KHP95/gradutaion_project/paper.pdf

KSME Template | 1
<응용논문> | DOI http:/ /dx .do i . org / 1 0 . 3 7 9 5 /KSME- A B . 2 0 1 4 . 3 8 . 0 . 0 0 0 | I SS N 1 2 2 6 -0 0 0 0

2288-0000(Online)

## 행성 탐사 로버 배터리 자동 교체 시스템 개발

### 김학중* · 민선기*† · 박경훈** · 유상은**† · 진상민*** · 홍창민***† (지도교수 : 장대성)

* 한국항공대학교 항공 우주 및 기계공학과

### Planet exploration rover battery automatic replacement system development

Hak Jung Kim*

, Sun Ki Min*†, Kyoung Hoon Park**

, Sang Eun Yoo**†, Sang min Chin*** and Chang Min Hong***†

* Dept. of Aerospace and Mechanical Engineering, Korea Aerospace Nat’l Univ.

(Received July 8, 2020 ; Revised July 9, 2020 ; Accepted July 10, 2020)

Key Words: System Engineering(시스템 엔지니어링), Micro Controller Unit(마이크로 컨트롤러), Path Plan (경로 계획), Robot Arm(로봇팔), Manipulator(매니퓰레이터) Kinematics(기구학) End-Effector (엔드이펙터), Mechanical Engineering Design(기계설계)

초록: 배터리 교체가 필요한 상대 로버 근처에서 주어진 방향 정보를 이용하여 사용된 배터리를 수거하 고, 동체에 장착된 배터리를 꺼내어 상대 로봇에 삽입하는 다관절 로봇팔을 구현을 목표로 제작하였다. 시스템 엔지니어링 개념을 통하여 제한된 예산과 시간동안에 로봇팔 제작을 실시하였다. 실제 모델의

구동 환경은 지구가 아닌 화성을 목표로 하였기 때문에 지구에서의 구동 가능한 모델의 재료와 크게 상이하다. 제작시간 및 제작비용을 고려하여 실제사이즈와 동일한 Mock-Up 모델을 제작하였다.

Abstract: The goal was to implement a multi-joint robot arm that collects the used battery by using the given direction information near the opponent rover that needs to replace the battery, takes out the battery mounted on the fuselage and inserts it into the opponent robot. Through the concept of system engineering, the robot arm was manufactured for a limited budget and time. Since the driving environment of the actual model is aimed at Mars, not Earth, it is significantly different from the material of the model that can be driven on Earth. In consideration of the production time and production cost, the same mock-up model was produced.

†Corresponding Author, dsjang@kau.ac.kr
Ⓒ 2020 The Korean Society of Mechanical Engineers

2 | 김학중․민선기․박경훈․유상은․진상민․홍창민
1. 서 론

1.1 Requirement

1) 500g의 배터리팩을 잡아서 하나의 장착 위치 에서 분리하고 다른 장착 위치에 삽입 및
결합할 수 있어야 한다.
2) 60초 이내에 자차의 배터리 팩을 꺼내고 상대 로버의 빈 장착 위치에 삽입해야 한다.
3) 60초 이내에 상대 로버의 배터리 팩을 꺼내고 자차의 빈 장착 위치에 삽입해야 한다.
4) 배터리 수거와 삽입은 자차에서 전방 좌우 ± 45, 거리 20cm~60cm 범위에 있는 상대 로버에 대해 수행할 수 있어야 한다.
5) 로봇팔 및 그 지지대와 제어 장치의 총 질량 합은 4kg 이내여야 한다.
6) 로봇팔은 운용될 환경 조건을 만족해야 한다.

1.2 Mission Statement – Hardware

로봇팔의 제어 특성과 여러 변수는 단순히 프로
그램 상에서만 발생하는 것이 아니라, 설계과정
과 실제 제작과정의 차이에서도 기인한다. 아무
리 설계가 이상적으로 잘 되어 있다 한 들 제작 과 조립을 고려하지 않았을 때, 자원 낭비로 이 어지며 이는 프로젝트를 진행함에 있어서 시간
지연 요소로 작용할 것이다. 이번 임무에 요구되는 로봇팔은 우주환경 내지

타 행성에서 정상적인 운용이 가능한 로봇팔로, 자중의 최소 1/8에 해당하는 물체를 자유롭게

Pick & Place가 가능해야 한다. 이를 충족하기 위해서는 다음과 같은 제약조건이 따른다.
- 더 가벼운 로봇팔은 우주환경까지의 운송비를
절약하는데 기여한다.
- 심한 온도차에서도 정상적인 작동이 가능해야
한다.
- 기계적으로 충분한 강도를 가져야 한다.
- 임무수행 범위 내에서 자유로운 동작 및 임무 수행이 가능해야 한다.

1.3 Mission Statement – Simulation

로봇팔이 원하는 효율적으로 원하는 운동을 수

학 공식적으로 계산하며 미션을 수행할 수 있도
록 로봇팔의 특성을 조절하는 역할을 한해야 한
다. 물체를 자유롭게 Pick & Place 하기 위해서 최적의 설계를 하기 위해서 다음과 같이 진행하
고 있다.
- 로봇팔 모델링을 통해 좌표축 및 이동행렬을
결정한다.
- 자코비안(Jacobian) 행렬식 계산을 통해 각 조 인트의 화전각과 각 링크 길이를 통한 엔드이펙
터의 위치 및 자세를 유도한다.
- 엔드이펙터가 이동할 경로의 좌표를 시간축에
대하여 정의하는 Path-plan
⦁ Wrist의 path-plan
⦁ 엔드이펙터의 path-plan
- 시뮬레이션 수행
- 카메라로부터 입력받은 정보에 대한 정보를
받아 그에 맞게 path-plan을 계산하고, 동작 을 어떤 순서로 진행할지에 대해 흐름 전개

1.3 Mission Statement – Software

로봇팔을 원하는 운동으로 작동시키기 위해서는
적절한 코딩과 그에 알맞은 프로세서가 필요하
다. 이를 충족시키기 위해서 소프트웨어팀은 다
음과 같은 기술을 충족시켜야 할 것이다.
-프로세서 선정 및 프로세서에 알맞은 코딩 능력 발전
-영상정보를 받기 위한 통신
-정보를 통하여 서보를 구동
-순차적인 동작을 구동하기 위한 알고리즘

KSME Template | 3

1.4 PBS

우리는 Design을 체계적으로 알아보기 위해 PBS 를 작성하였고 다음과 같다.

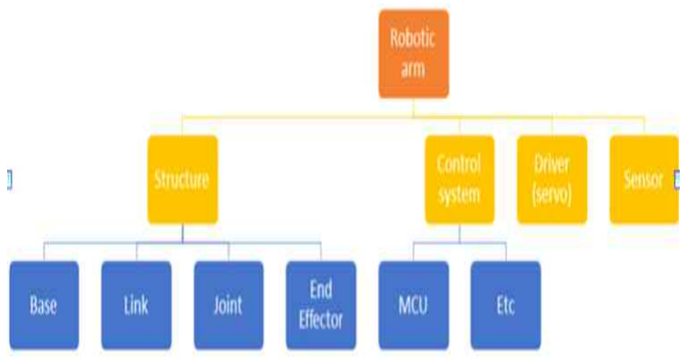
[picture p3: figure]

-Structure: 로봇팔의 기계적인 구조
-Base: 로봇팔이 설치될 지지대
-Link: 관절과 관절을 이어주는 팔
-Joint:구동기를 설치해 움직임을 만들어내는 관 절부품
-End effector: 로봇팔의 끝에 달려 배터리를 교환하는 작업(Ex. grip, rotate)을 수행하는 장 치(ex. Gripper or em holder)
-Control system: Driver의 제어를 수행하기 위 하여 필요한 회로 등을 포함한 전자장비들의 집
합
-MCU: 마이크로 컨트롤러 유닛. 프로그램이 설치 되어 구동기에 신호명령을 내리는 장치
-Driver: 구동기. Control system의 신호를 받아 움직임을 만들어내는 장치 (Ex. Servo, linear motor, 유압장치 등)
-Sensor: 제어에 필요한 각종 외부 정보들을 수 집하는 장치

1.5 V Shape Diagram

Requirements 중 설계 및 제작에서 가장 중요하 게 고려해야 할 부분은 1, 4, 5, 6번이며, 2번 및 3번의 달성을 위해서는 설계가 소프트웨어 디 자인에 대하여 친화적일 필요가 있다. 다시 말해
모든 | 조건을 | 고려해야 | 하며, | 이를 | 고려한
V-shape diagram은 아래와 같다.

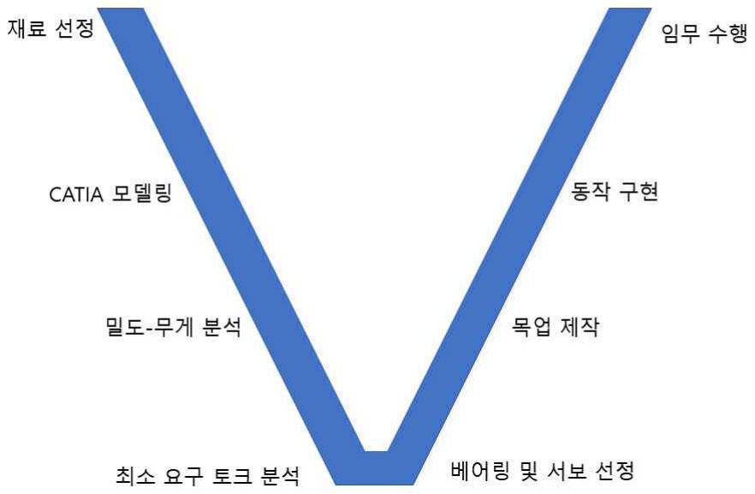
[picture p4: figure]

Fig. 2 Hardware Design V shape diagram

2. 본 론

2.1 design model weight expectation

무게 대비 payload 조사: 우리는 설계를 시작하 기에 앞서서 로봇 팔이 과연 500g을 들려면 어느 정도의 무게여야 하는지 알아보기 위해서 자료를
찾아 10kg 미만의 사례 중 10개를 선택하여 보간 한 결과 다음과 같이 얻을 수 있었다,

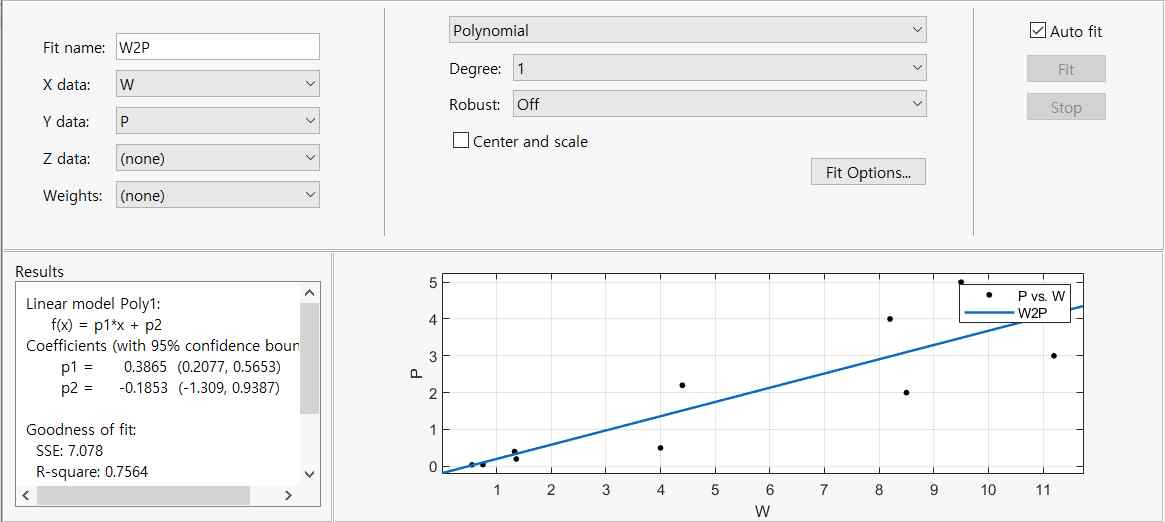
[picture p5: figure]

Fig. 3 weight-payload root mean square plot

식에 4kg을 대입한 결과 충분히 500g을 이상을 들 수 있다는 결과가 나왔다.

2.2 Hardware

2.2.1 Material Selection

로봇팔의 재질은 무게와 페이로드에 따라 적절
히 선정해야 한다. 또한, 지상에서 운용되는 로 봇암과 달리 항공우주분야에서 운용하는 로봇팔
은 무게가 운용 효율과 직결되어 로봇팔 자체의

4 | 김학중․민선기․박경훈․유상은․진상민․홍창민

무게에 대한 합리적 고려가 필요하다. 따라서 재
질 선정에 앞서 고려할 수 있는 재료들과 화성탐
사선 Curiosity의 로봇팔에 사용되었던 재료를 주요 특성에 따라 정렬하였다. Ti6Al-
| 4V | Al-707 5 | AS4/35 01-6 | PEEK | AL606 1
밀도 (g/cc) | 4.43 | 2.81 | 1.60 | 1.26-1 .50 | 2.70
탄성계수 (GPa ) | - | 71.7 | 147, 10.3 | 2.2-6. 48 | 68.9
인장강도 (Mpa ) | 896 | 276 | 2280 | 48-26 5 | 117
극한 인장 변 형률 (%) | - | 17 | 1.5 | 1.5-11 0 | 25

열팽창계수
(
/℃) | - | 23.6 | -0.9 | 4.7-
600 | 25.2

Table. 1 materials used in Curiosity, Mars Probe, and Properties of CFRP(UD type) and PEEK

인장강도 및 열팽창계수만 고려한다면 CFRP인
AS4/3501-6이 월등한 성능을 가지고 있음을 알 수 있다. 그러나 다른 재질에 비하여 이방성 재 질이고 단가가 비싸며, 충격에 의한 재료의 파괴 가 지속적으로 진행되는 점으로부터 우주쓰레기
및 행성 내 모래폭풍 등의 외부 충격에 취약하다 고 판단하였다.
Ti6AL-4V은 티타늄 특수합금으로서 물성이 뛰어 나지만 가공이 어려워 단가 상승이 예상되며, 재 료를 구하는 것 부터가 쉽지 않다. Al 7075의 경 우 특수한 경우를 제외하고 대중적으로 사용되지
않아 제한된 예산 하에서 실제 제작에 활용하기
어렵다고 판단하여 Al6061을 주 재료로 선정하 였다.

2.2.2 Design

2.2.2.1 Robot arm design
로봇팔의 형상은 임무수행을 위해 최적화되어야
한다. 또한 제한된 예산 내에서 Requirement를 만 족하기 위해서는 재료를 고려한 설계가 필수적이
다.

앞서 로봇팔의 주재료를 Al6061으로 하기로 하였 으므로 이를 기반으로 요구되는 로봇팔의 링크
규격을 단순 보 가정을 통해 구하였다.

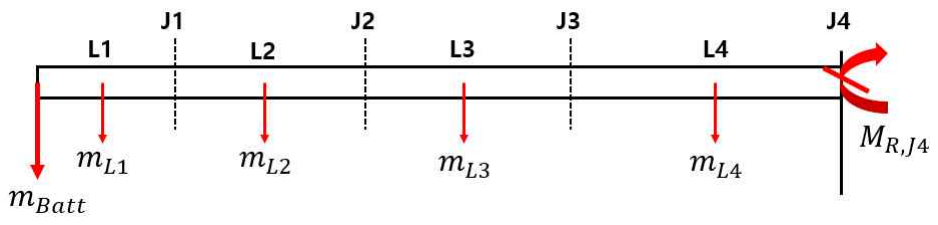
[picture p6: figure]

Fig. 4 단순 보 가정, 집중하중으로 가정한 로봇 팔의 링크

안전계수를 4로 하였을 때, Al6061을 재료로 하 는 원형 링크의 규격은 D25 1T이다. 또한, 이때 각 조인트에 가해지는 토크는 다음과 같다.

이러한 결과를 기반으로 서보를 선정하고, CATI A를 이용하여 모델링 한 결과는 아래와 같다.

| 서보무게 (g) | 암 무게 (g) | 암 길이 (cm) | 총 모멘트 (kg.cm)
J4 | 135 | 250 | 12 | 9.48
J3 | 60 | 112 | 20 | 30.1
J2 | 65 | 128 | 20 | 54.42
J1 | 900 | 171 | 30 | 122.01

Table. 2 The amount of torque applied to the joint

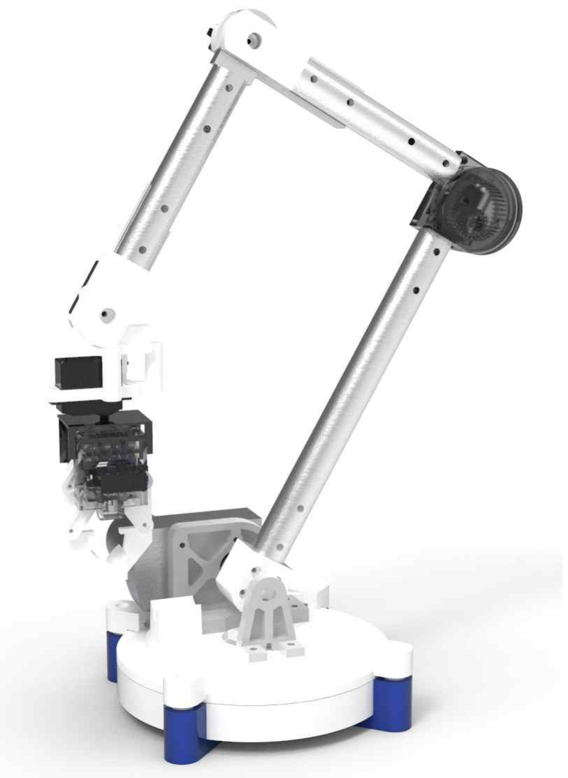
[picture p7: figure]

Fig. 5 Final design completed/manufactured Robot arm model

KSME Template | 5

이때 재료는 PLA(Polylactic Acid)를 사용했으며, 이는 실제 모델에서는 사용하지 않는 재료이지

만, 프로젝트의 기한이 최대 1년인 점, 예산이 학 기당 최대 100만원으로 한정된 점, 충분한 해석 및 선행 연구가 진행되지 못한 점으로부터 프로
젝트 진행과 함께 모델링의 수정이 불가피하므로
3D printer를 이용해서 설계 수정 및 즉시 반영을 통해 단기간에 목표를 달성하기 위해 사용하였
다. 2.2.2.2 End-Effector Design

-Requirements

배터리팩을 잡고 배터리팩의 무게+로봇팔 작
동시의 관성력 을 견딜 수 있어야 한다. 전체질 량은 200g 이하여야 한다.

-설계품 추정

설계에 앞서 시판중인 엔드이펙터의 설계를 살펴
보았다. 그 결과 공통적인 구조를 발견하였다.

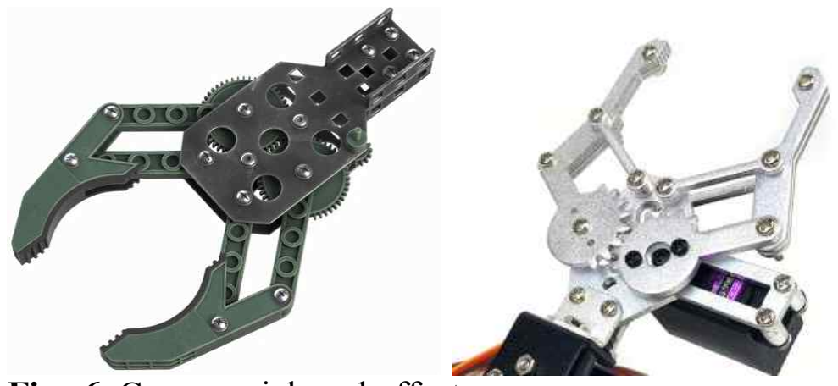
[picture p8: figure]

Fig. 6 Commercial end-effector

위와 같이 두 개의 평행한 링크가 그리퍼에 연결 되어 작동하는 방식이다. 그리퍼가 서로 대칭하
게 동작하기 때문에 내부 기어도 대칭구조로 되
어있다. 위의 구조를 토대로 설계하였다.

-그립과정에서 배터리팩 그립과의 간섭 해결

그림에서 표현된 바와 같이 그리퍼는 링크의 길
이를 반지름으로 하는 원호를 그리며 움직인다. 이 과정에서 배터리 그립과 그리퍼와의 간섭을

방지하려면 그리퍼가 그리는 자취를 따라서 배터
리팩의 그립을 설계하거나 반대로 배터리팩의 그
립이 그리는 자취를 따라서 배터리팩을 설계하여

야 한다. 배터리팩의 그립부분이 이미 설계가 되 어있었기 때문에 후자를 택하였다.

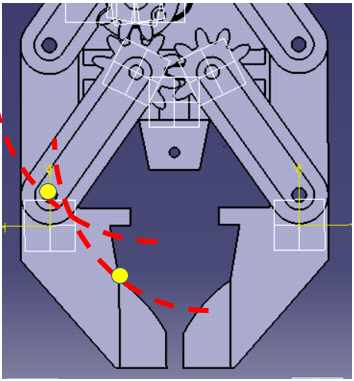
[picture p9: figure]

Fig. 7 Trajectory of gripper - 배터리팩 하중에 의한 토크 계산

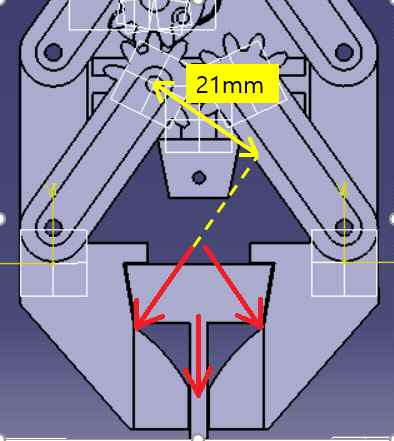
[picture p10: figure]

Fig. 8 Load appled and Moment arm

그림처럼 배터리팩을 잡았을 시에 배터리팩의 하
중의 작용점의 모멘트암의 길이는 21mm 이다. 하중과 모멘트를 정역학적으로 계산해보면 다음

과 같다.
cos ×
대칭구조이기 때문에 양쪽에 하중이 걸리는 것을
고려하면 총 모멘트는 다음과 같다. × ×

서보모터의 사양이 2.8~3.4 kg·cm 이므로 여유 가 있는 것을 알 수 있다. 그러므로 기어비 1:1 이 충분한 것으로 판단하였다.

6 | 김학중․민선기․박경훈․유상은․진상민․홍창민
- 내부 기어 설계
다음은 인벌류트치형을 그리기 위한 수치이다. 잇 수 N | 10
피치지름 d | 15 mm
입 력 각 a | 20 deg
- 모 듈 m= | m=1.5 mm

기초원지름 =14.0954 mm = cos

디덴덤지름 | =11.25 mm
어덴덤지름 | =18 mm

Table. 3 Gear Design Data

위 수치를 가지고 인벌류트 곡선을 그리고 기어
를 모델링하였다. 아래는 전체 모델링 결과이다

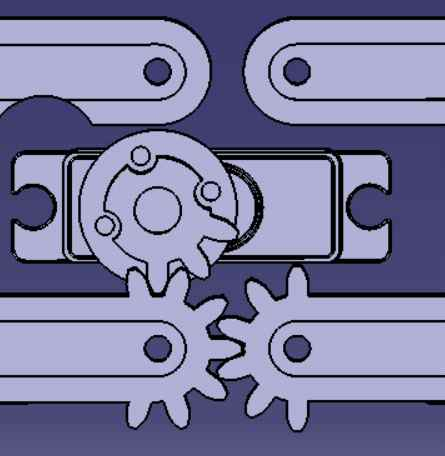
[picture p11: figure]

Fig. 9 Internal Gear structure

기어를 회전시켜가며 이의 간섭이 없음을 확인하
였다. 서보모터와 연결된 기어는 작동각도 55 에 필요한 이를 빼고 생략하였다.
2.2.3. Feature
이러한 로봇팔을 제작하는 과정에서 발생 가
능한 이슈들을 빠르게 피드백하기 위해선 높은
수준의 유지보수성이 요구되며, 이를 위해 전 파 트 볼트-너트 채결 방식을 통해 조립하였다. 볼팅 과정에서 발생하는 마찰열에 의해 3D Printer 출 력물이 적절히 변형되어 결합을 보다 단단하게
유지할 수 있었으며, 결합강도가 충분하지 않은

곳에는 플렌지 너트를 이용해 채결하여 스스로
풀리지 않도록 하였다.또한 3d Printer 출력 시 불 필요한 Support 생성에 의한 원재료 및 시간, 인 적 자원 낭비를 방지하기 위하여 설계 단계에서
서포트가 요구되지 않는 구조를 설계하는 것을
최우선 순위로 디자인하였다. 이를 위해 z축 방 향에서 형성되는 빈 공간을 최소화하고, 출력 시 에 적절한 온도 및 밀도 설정과 함께 서포트가
형성되는 각도를 조절하여 출력함으로서 보다 높
은 수준의 결과물 생산이 가능했다. 서보모터에 의한 동력전달의 경우, 소형 서보

모터의 축으로 사용되는 스파인으로부터 출력한
조인트가 미끄러지지 않게 하고, 반복된 움직임
으로 인해 마모되는 것을 방지하는 것이 중요하
다. 또한 기어 등 추가 부품이 늘어날수록 동력 전달 효율이 감소하므로, 최대 동력 전달을 위해 서는 직접 연결하는 방식이 제일 높은 기계효율
을 가진다. 이러한 점으로, 기성 서보 혼을 설계 형상에 맞게 변경하여 사용함으로써 발생할 수
있는 부품의 마모, 동력전달 효율 문제 등을 해 결하였다. 또한 이러한 축이 작고 축에 수직한
힘에 약하여 축 변형, 더 나아가 서보 모터 파손 등의 문제가 발생할 수 있다. 따라서 반대편에는 이러한 수직한 힘에 의한 변형을 막아줄 축을
AL6061 축을 D-shape 가공하여 추가로 설치하였 으며, 축 방향 수직하중에 의한 처짐, 흔들림 등 을 해결할 수 있었다.

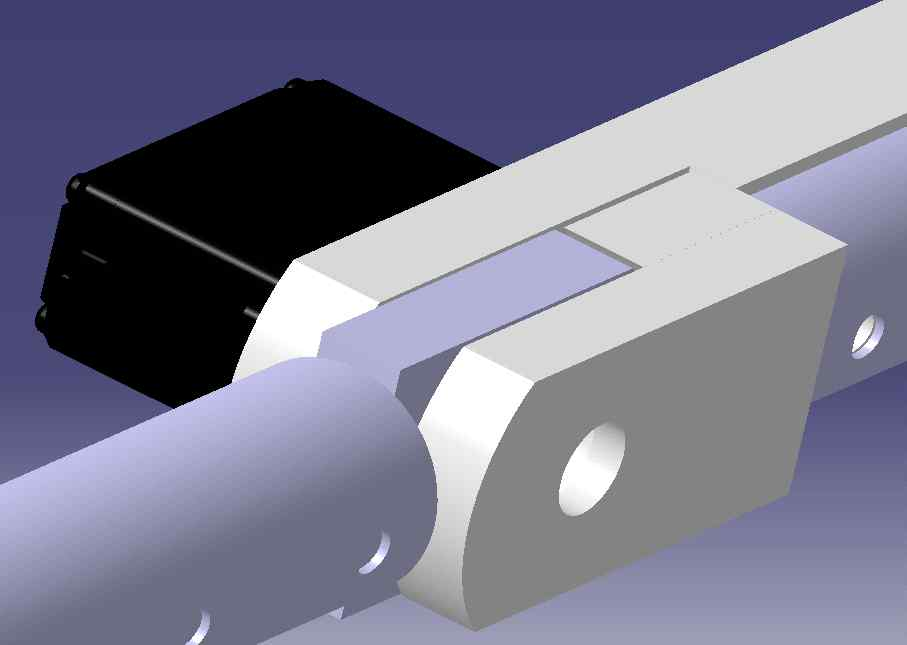
[picture p12: figure]

Fig. 10 Structure to prevent deformation by axial normal stress.

기저부의 경우, 작은 변형이 가장 큰 오차로 나 타나는 부분이므로 이를 방지하기 위한 롤러가이
드를 90도마다 설치하여 기저부 판의 구조적인
특성에 의한 흔들림을 방지하였다. 헤드에 8mm

KSME Template | 7

베어링의 일부분이 노출되어있어, m6볼트를 이용
하여 롤러가이드를 조립하게 되면 이러한 힘에
의해 베어링과 회전 플레이트가 접촉하게 된다. 이를 적절히 조절하면 흔들림을 잡는 동시에 원

할한 동작을 가능하게 할 수 있다.

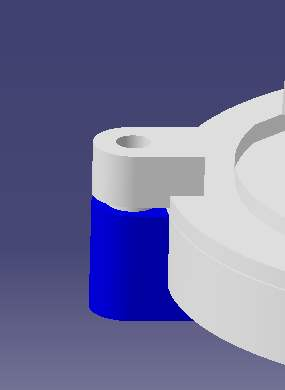
[picture p13: figure]

Fig. 11 Roller guide mounted on the base plate

2.3 Simulation

Requirements를 만족하도록 개념설계를 구체화하 고, 실제 제작에 앞서 가상의 정보를 가지고 실 제로 작동하는 일련의 과정을 구상 및 테스트해
보아야 한다. 시뮬레이션은 하드웨어 없이도 테
스트할 수 있으며, 알고리즘을 개발하고 시험하
기 위해 필요하다. 시뮬레이션을 통하여 업무분
담 및 테스트가 수월해질 수 있다.

2.3.1 Modeling

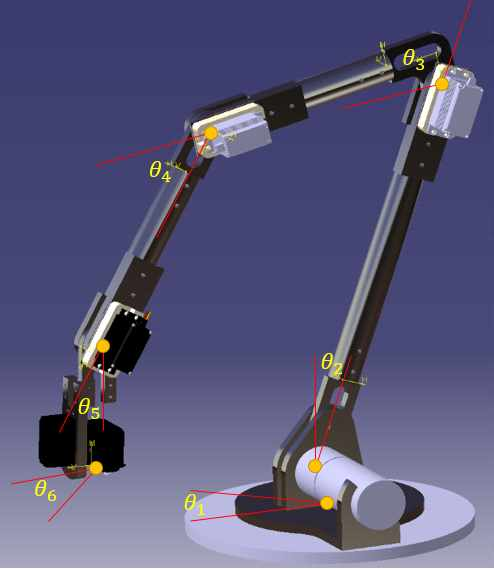
[picture p14: figure]

Fig. 12 Robot Arm

우선 6자유도로 모델링 하였다. 그 이유는 다음 과 같다. ① 5자유도의 경우 엔드이펙터와 지지대를 제외

한 로봇팔이 2자유도이므로 로버의 자세와 위
치에 대한 유연한 대응에 한계가 있다. ② 로버의 자세에 따라 엔드이펙터의 자세를 변

화시켜야 하므로 회전도 필요하다. 먼저 카티아로 전체적인 형상을 그려보고 이를

토대로 로봇공학 정기구학 스터디를 진행한 후
Universal 좌표계에서 엔드이펙터 좌표계까지의 Transformation 행렬을 만들어 보았다. 이를 통 해 엔드이펙터의 자세와 위치를 알 수 있다.
Transformation 행렬은 다음와 같다.

8 | 김학중․민선기․박경훈․유상은․진상민․홍창민

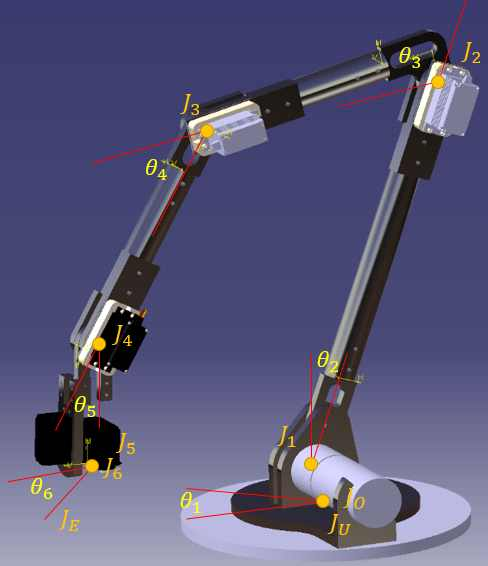
[picture p15: figure]

Fig. 13 Robot Arm

Ju=정면을 x, 왼쪽을 y, 위를 z로 하는
FLU좌표계로 설정
J0= 로 yaw 회전을 한 좌표계
J1=지지대로부터 높이만큼 이동한 좌표계
J2= 로 pitch 회전 후 L1길이방향으로 J2까지 이동한 좌표계
J3= 로 pitch 회전 후 L2길이방향으로 J3까지 이동한 좌표계
J4= 로 pitch 회전 후 L3길이방향으로 J4까지 이동한 좌표계
J5= 로 pitch 회전 후 L4길이방향으로 J5까지 이동한 좌표계
J6= 로 yaw 회전 후 L5길이방향으로 J6까지 이동한 좌표계
Je= 로 roll 회전 후 엔드이펙터 grip point까지 이동한 좌표계

위에서 J1에서 J2로 이동하는 과정에서 을

곱해준다. 여기에서 x축 중심으로 -90 도 회전 후 y축 중심으로 -90 도를 회전한다. 이는 로봇 공학에서 통상적으로 x축을 링크길이 방향, z축 을 조인트 회전축 방향으로 맞추기 때문에 이를
만족시키기 위함이다.

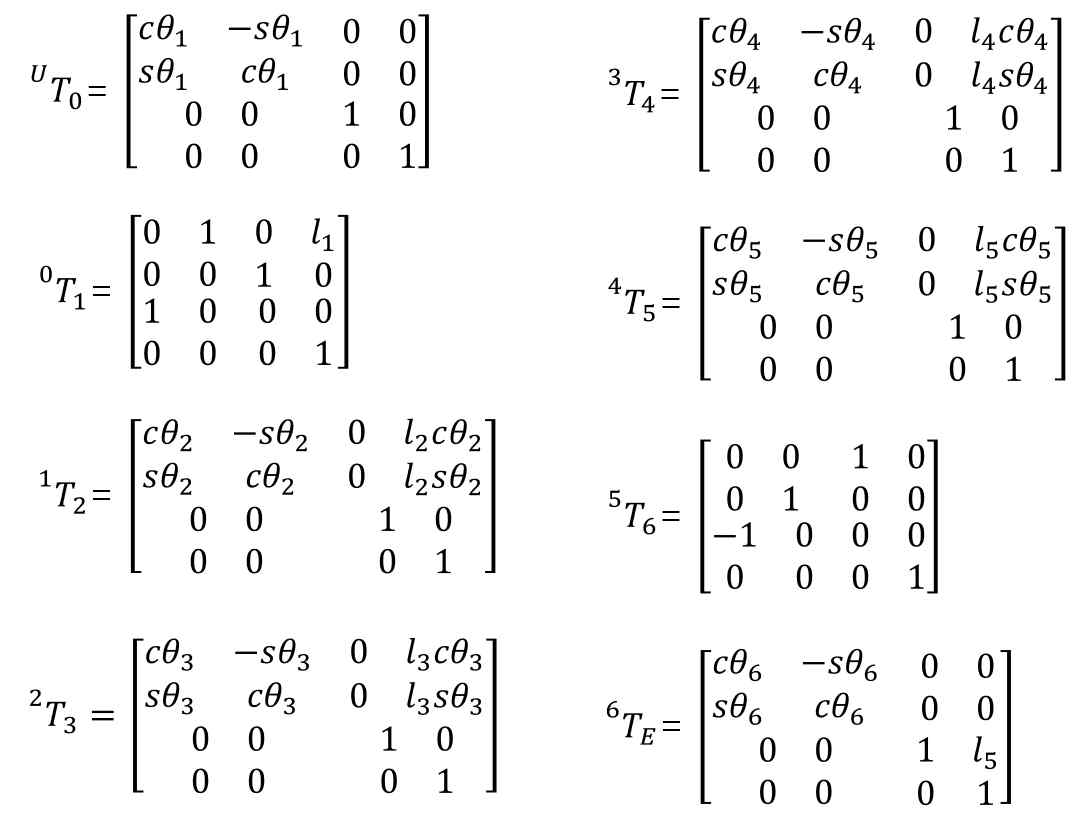
[picture p16: figure]

Fig. 14 Translation Jacobian Matrix
위 행렬을 모두 곱하게 되면 Universal 좌표계에 대한 엔드이펙터의 자세와 위치를 알 수 있다. 하지만 여기에서 지지대와 1번 조인트 사이의 거

리와 엔드이펙터를 생략하여 단순화 시켜서 시뮬
레이션을 진행하기로 하였다. 그 이유는 다음과
같다. ① 모두 계산할 경우 식이 매우 복잡해진다. ② 로버 배터리의 자세에 따라 엔드이펙터의 자

세도 변하여야 한다. 이 경우 4 번 조인트의
좌표를 배터리에서 수직방향으로 엔드이펙터 길
이만큼 떨어진 지점에 일치하도록 제어하는
것이 편하다. 단순화된 로봇팔을 FLU 좌표계로 나타내면 다음

과 같다.

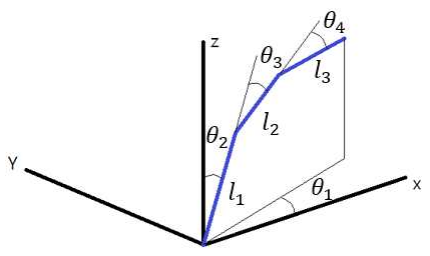
[picture p17: figure]

Fig. 15 Link coordinate

이를 토대로 끝점의 위치좌표를 계산하면 아래와

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

10 | 김학중․민선기․박경훈․유상은․진상민․홍창민
1)
| 을 동시에 제어하는 방법

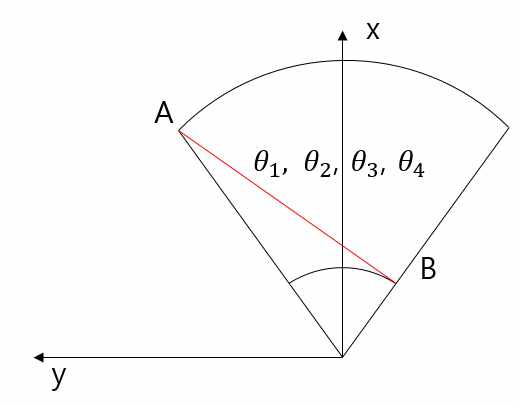
[picture p18: figure]

Fig. 16 Sequence Case 1

위 그림은 경로를 xy평면에 정사영시킨 것을 나 타낸 것이다. 목적지점 A와 B 사이를 직선으로 연결한 최단 경로(빨간색) 를 따라 wrist를 이동 시키는 것이다.

- 을 시간에 대한 함

수로 정의하는 것이 필요하다. ※ 로봇팔이 두 지점 사이를 이동하면서 가 변

함에 따라 wrist와 원점사이의 거리가 점점 작아 지게 된다. 이 경우 의 각속도를 조절해줄 필

요가 있다. 그리고 의 변화에 따라 wrist의 위

치가 결정된다. 이 상황에서

- 중에서

redundancy가 한 개 발생하여

- 의 값이

무수히 많아진다. 따라서

- 중 한 각도의

값을 정해주어야만 나머지 두 각을 유한하게 제
어할 수 있을 것으로 예상된다. 시뮬레이션을 통해 이 제어가 가능한지 알아보고

만약 불가능하다면 자유도를 제한하여 나머지 두
각을 유한하게 제어하는 방법을 모색하기로 한
다.
2) 제어와
- 제어를 시퀀스를 나눠

서 하는 방법

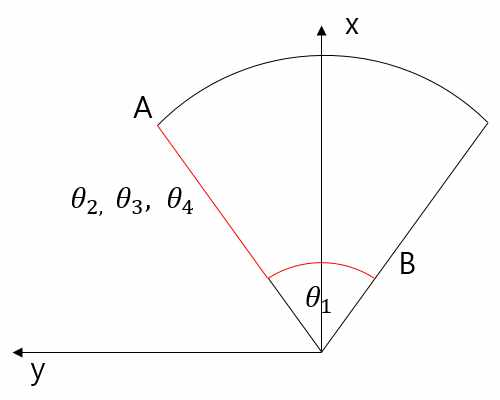
[picture p19: figure]

Fig. 17 Sequence Case 2

지지대 | 회전()과 | 로봇팔 | 조인트회전

(

- )을 나눠서 제어하여 목적지에 도달하

는 것이다. 이 경우도 마찬가지로 wrist의 위치 에 따른

- 값이 무수히 많다. 다만 나눠서 제어하므로 2차원화 되어 비교적 제

어가 간단해진다. 하지만 경로가 길어져 임무 수 행에 시간 소모가 커지는 단점이 있다. 각 방법의 장단점을 정리해 보면 다음과 같아진

다.

최종적으로는 | 1)의 | 방식을 | 채택하였으며,
pathplan과 역기구학(인버스 자코비안)을 이용하 면 redundancy가 발생하지 않음을 확인할 수 있 었다.
| 동시제어 | 시퀀스를 나눠서 제어
장점 | 경로가 짧다. 임무 수행 시간이 짧아진다. 배터리 소모가 적 다. | 연산이 비교적 간 단하다. 제어가 쉽다. 단점
| 더 많은 연산이 요구된다. 제어가 어렵다. | 경로가 길다. 임무 수행 시간이 길어진다. 배터리 소모가 크

다. Table. 6 Pros and Cons of path plan methods

KSME Template | 11

2.3.4 Simulation Production Details

①실제 모델 길이에 따른 링크 및 엔드 이펙터
표시
②자코비언 행렬을 이용한 패스 플래닝
③배터리 교체 알고리즘에 따른 경로 설정
④배터리 교체 그립 구현
⑤제한 영역 설정

제한 영역 설정 고려 사항

①링크의 길이를 통해서 나오는 최대 도달거리에
의한 제한 영역

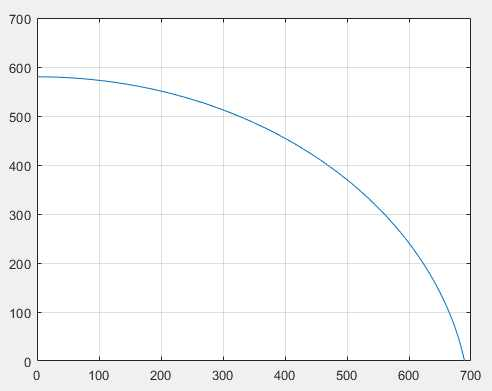
[picture p20: figure]

Fig. 18 Maximum Reach length

그래프의 원점이 기저부의 회전중심이며 곡선 이
내의 영역에서는 안정적인 이동이 가능하다. ②구조적 한계의 각도 제한으로 인한 제한 영역

구조적 각도에 의해 최대각도 혹은 최소각도가
제한된다. 토크를 위해 서보 작동각도가 제한된
다. 시뮬레이션을 통해 다양한 조합을 시도하여
임무지역을 만족하며 가장 넓은 작동범위를 가지
도록 그리고 기저부 작동제한 영역이 배터리 보
관함위치와 겹치지 않도록 가장 적절한 각도 제
한을 선정하였다. 제한 각도는 아래와 같다. 각도를 제한하여 시뮬레이션한 결과는 아래와 같

다. 파란 지역은 조인트 중 하나라도 작동범위를

넘어서는 구역을 표시한 것이며, 검은 지역은 튕 김 구역(물리적으로 링크의 길이가 부족하여 불
가능한 구역)을 표시한 것이다.

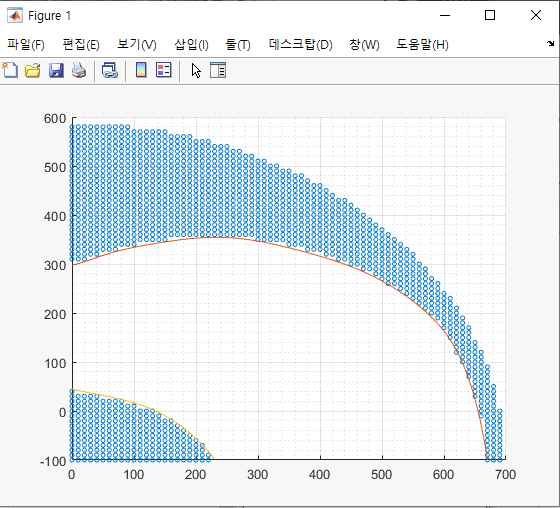
[picture p21: figure]

Fig. 19 Reach length limitation
위의 그래프의 결과를 통해 offset을 두고
polynomial line fitting하여 제한 영역을 설정 하였다. 제한 영역에서는 로봇암이 작동하지 않
으며, 목표지점을 재입력 하도록 하였다.

2.3.4Simulation Sequence

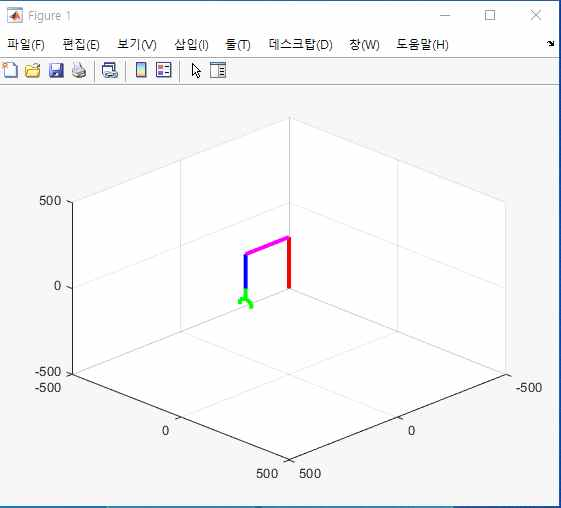
[picture p22: figure]

Fig. 20 Standby position

-85°≤﷐﷯≤ 90° <범위: 175도> | 37°≤﷐﷯≤ 107° <범위: 70도>
1°≤﷐﷯≤ 142° <범위: 140도> | -40°≤﷐﷯≤ 90° <범위: 130도>

Table. 7 Operating range of each joint

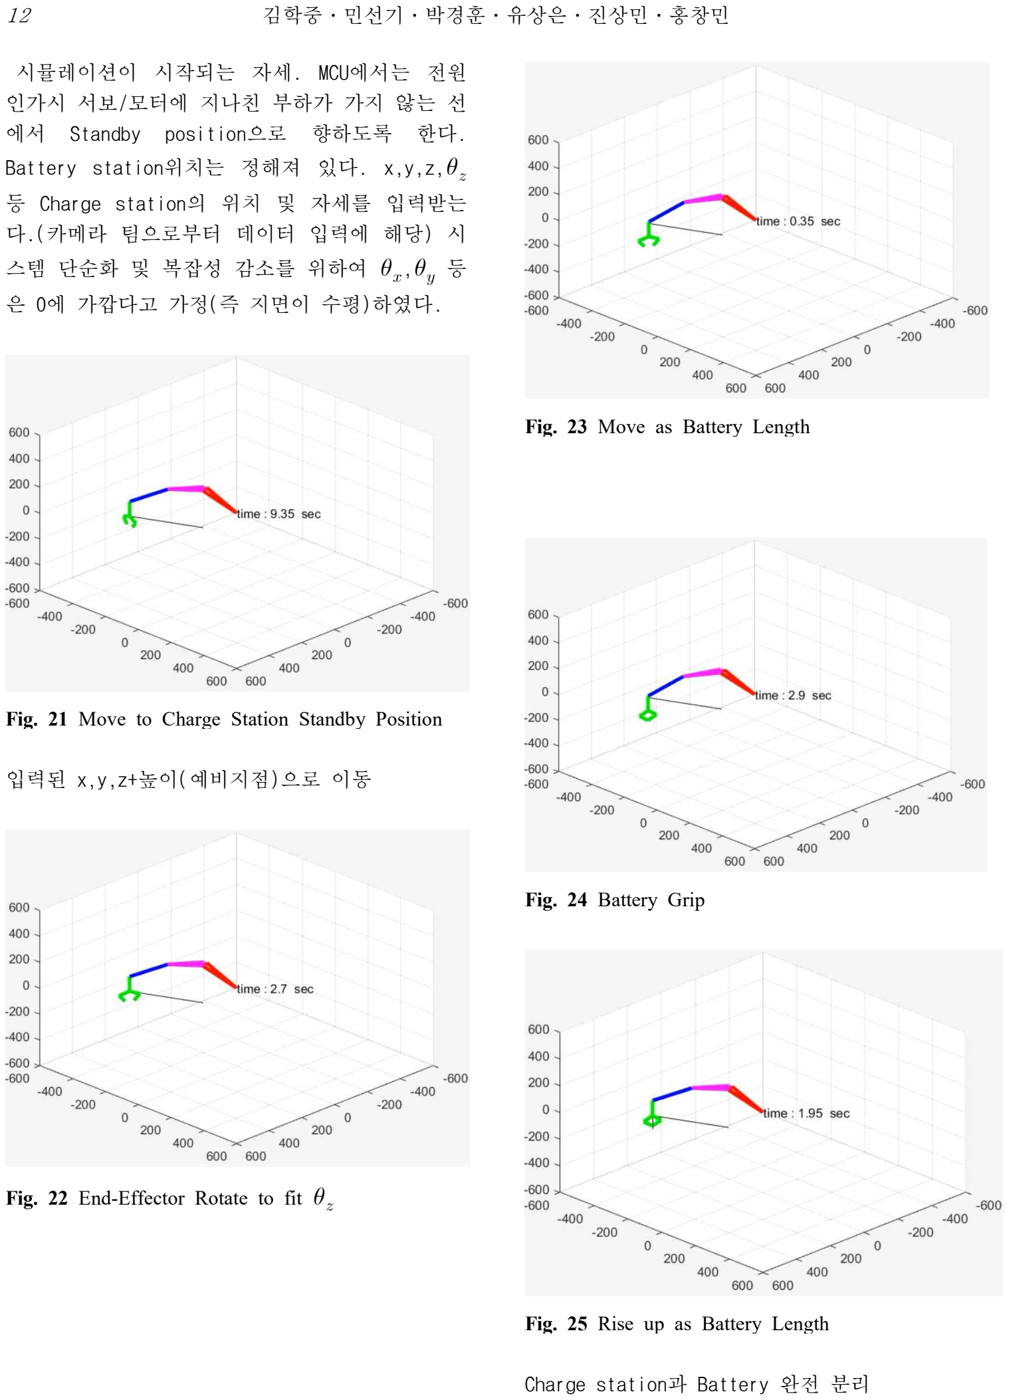
[picture p23: page 12]

12 | 김학중․민선기․박경훈․유상은․진상민․홍창민

시뮬레이션이 시작되는 자세. MCU에서는 전원
인가시 서보/모터에 지나친 부하가 가지 않는 선
에서 Standby position으로 향하도록 한다. Battery station위치는 정해져 있다. x,y,z, 등 Charge station의 위치 및 자세를 입력받는

다.(카메라 팀으로부터 데이터 입력에 해당) 시 스템 단순화 및 복잡성 감소를 위하여 , 등

은 0에 가깝다고 가정(즉 지면이 수평)하였다.

Fig. 21 Move to Charge Station Standby Position

입력된 x,y,z+높이(예비지점)으로 이동

Fig. 22 End-Effector Rotate to fit

Fig. 23 Move as Battery Length

Fig. 24 Battery Grip

Fig. 25 Rise up as Battery Length

Charge station과 Battery 완전 분리

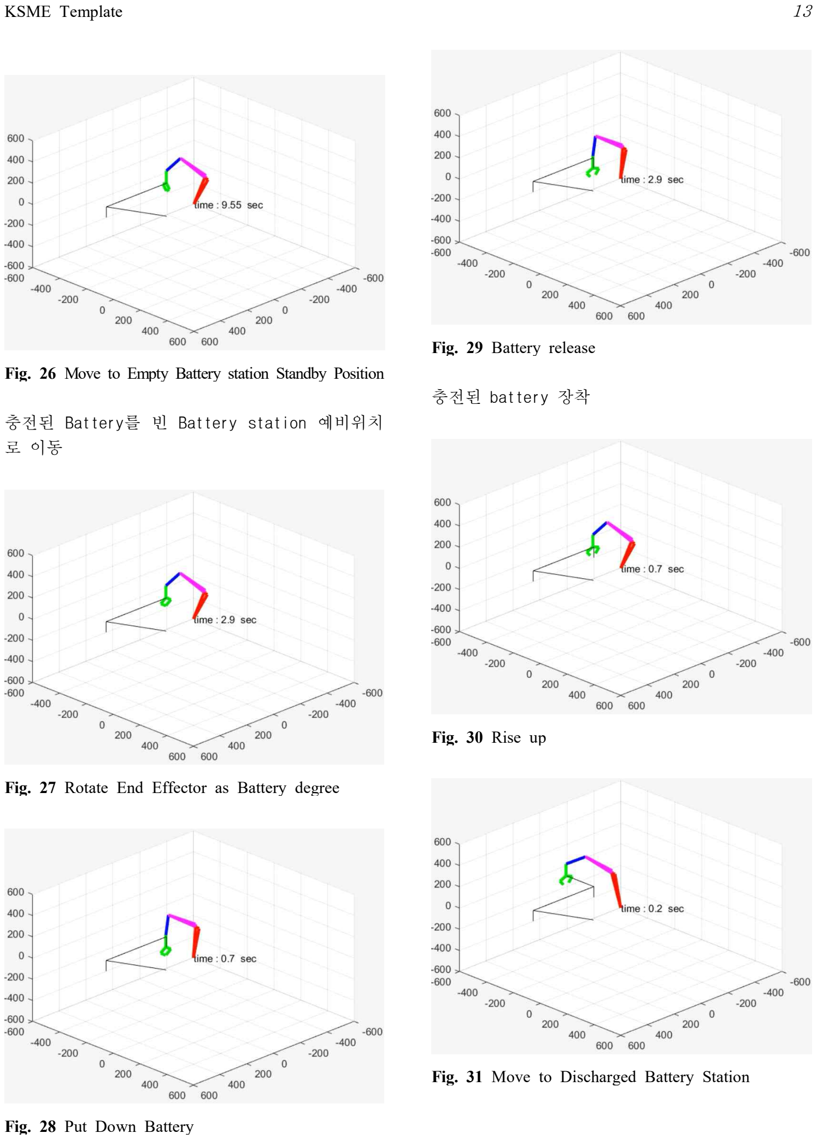
[picture p24: page 13]

KSME Template | 13

Fig. 26 Move to Empty Battery station Standby Position

충전된 Battery를 빈 Battery station 예비위치 로 이동

Fig. 27 Rotate End Effector as Battery degree

Fig. 28 Put Down Battery

Fig. 29 Battery release

충전된 battery 장착

Fig. 30 Rise up

Fig. 31 Move to Discharged Battery Station

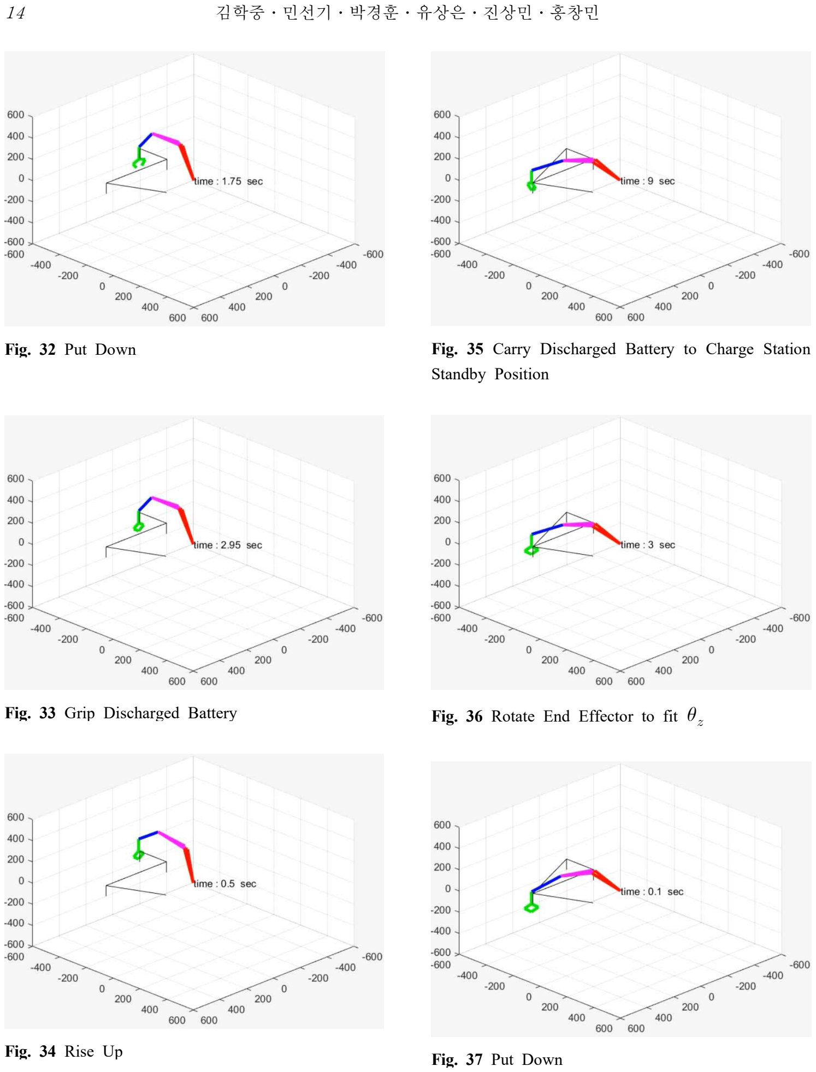
[picture p25: page 14]

14 | 김학중․민선기․박경훈․유상은․진상민․홍창민

Fig. 32 Put Down

Fig. 33 Grip Discharged Battery

Fig. 34 Rise Up

Fig. 35 Carry Discharged Battery to Charge Station Standby Position

Fig. 36 Rotate End Effector to fit

Fig. 37 Put Down

KSME Template | 15

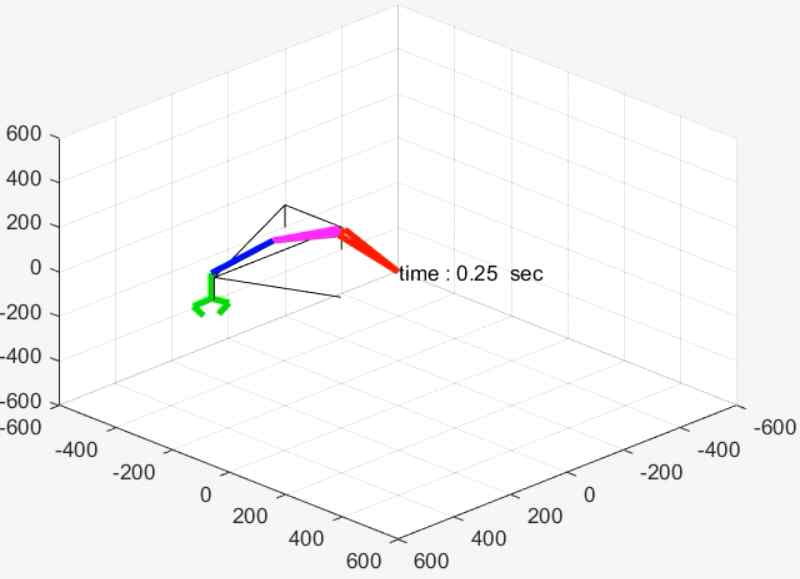
[picture p26: figure]

충전시작

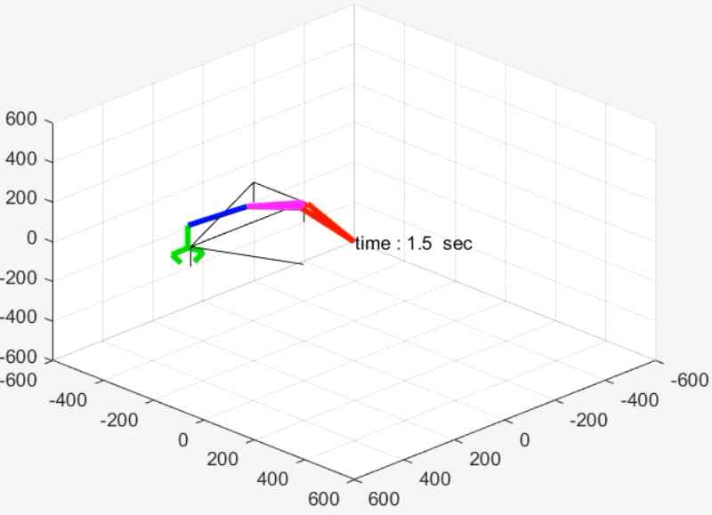
[picture p27: figure]

Fig. 39 Rise Up

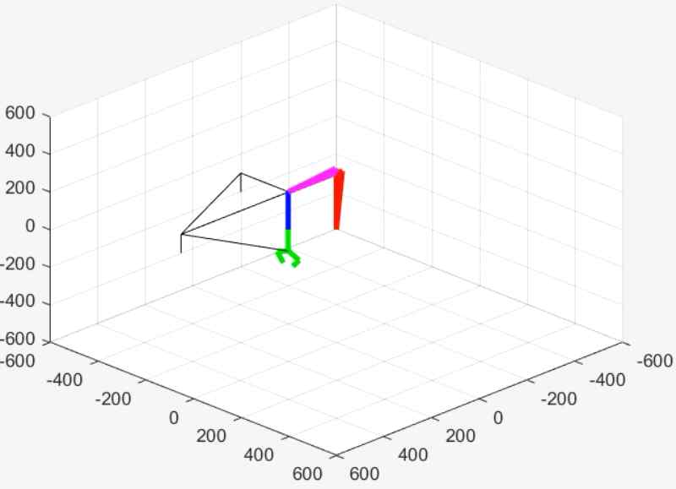
[picture p28: figure]

Fig. 40 Come Back to Standby Position

다음 명령 대기.

2.4 Software

2.4.1 Hardware configuration

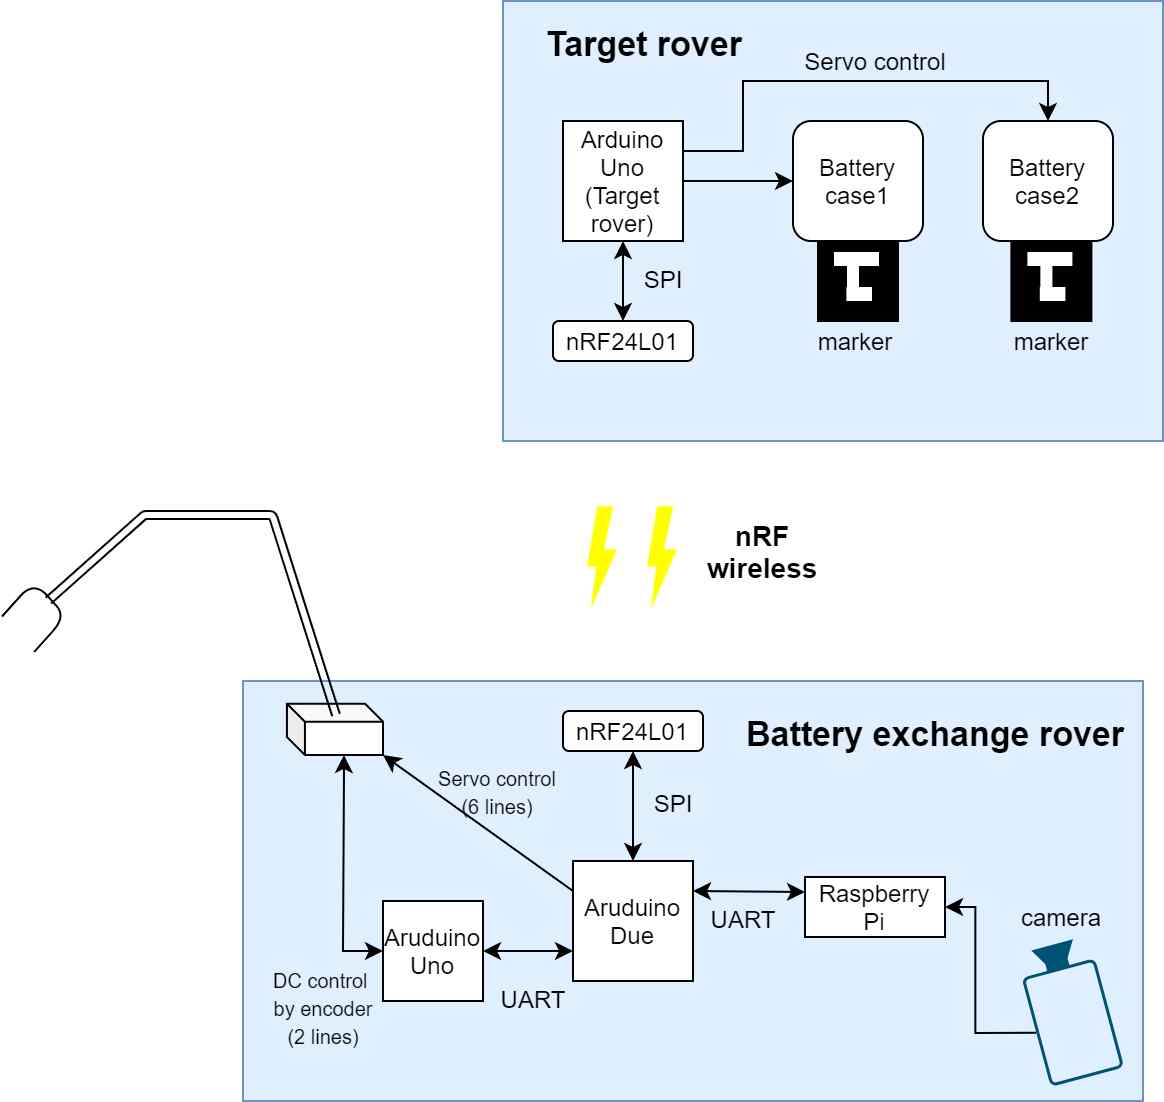
[picture p29: figure]

Fig. 41 Rover hardware design
위 그림은 로봇팔의 구성도를 나타낸 그림이고
각각의 구성요소들에 대한 설명은 다음과 같다. Target rover의 구성품

l nRF24l01
이 무선통신 모듈은 Target rover로부터 준비교체 명령을 받아 이를 Arduino uno에 전달하는 역할 을 한다. nRF모듈을은 갸격이 저렴하고 안테나 없이도 50m정도까지 안정적인 통신을 진행할 수 있어 임무를 수행하는데 적합하다. l Arduino uno

Target rover를 제어 한다. nRF로부터 받은 데이 터를 처리하여 배터리 케이스에 달려있는 모터에
명령을 보내 임무수행 전 준비를 한다. Battery exchange rover의 구성품

l Raspberry Pi
카메라로 배터리의 마커를 영상처리하여 UART 통 신으로 Arduino Due에 배터리 마운트 좌표 및 각 도를 보낸다. l Arduino due

아두이노 프로세서중 가장 높은 처리속도와 변수
저장공간을 가지고 있다. Raspberry Pi와 Uno, nRF24L01 및 컴퓨터와 통신하여 임무수행을 위한 메인프로그램을 구동한다.

Fig. 38 Battery Release

16 | 김학중․민선기․박경훈․유상은․진상민․홍창민

l Arduino uno
로봇 팔의 기저부에 있는 DC모터 2개의 별도 피 드백 루프를 구성하고, Calibration값들을 저장 하는 역할을 한다.

2.4.2 Algorithm
임무수행 알고리즘은 아래와 같다.

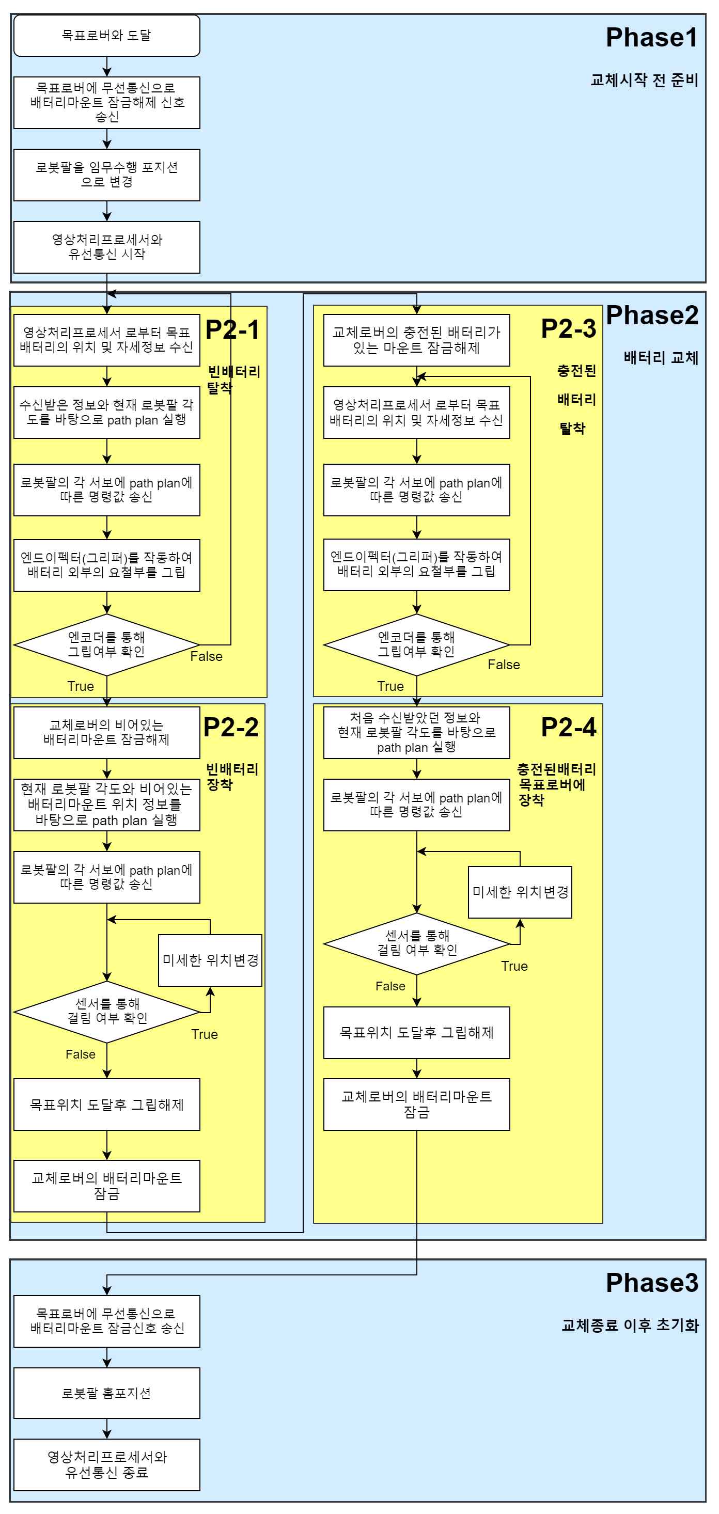
[picture p30: figure]

Fig. 42 Mission algorithm
임무수행은 총 3단계의 Phase로 나뉘어 진행된

다.
Phase1은 교체전 준비를 진행하는 단계이며, 이 때 목표로버와 무선통신하여 배터리 마운트의 덮
개부분을 열고, 영상처리 프로세서인 라즈베리
파이와 통신하여 배터리 마운트의 좌표를 수신한
다.

Phase2는 path-plan을 수행하여 배터리 교체작업 을 실행하는 단계이다. 이때 배터리 교체작업은
4개의 sub-phase로 나뉘어 진행되며, 각 단계마 다 path-plan을 진행한 후 확인작업을 실행하고, 이상이 없을시 다음 sub-phase로 넘어가는 방식

이다. 각 sub-phase는 좌표로 이동->하강->그립 또는 그립해제->상승 의 작업을 실행하며, 이에 따라 sub-phase당 path-plan의 실행횟수는 3번이 다. 이에따라 Phase2에서 총 12번의 path-plan이 이루어진다.

Phase3는 배러티 교체작업 이후 마무리작업을 진 행하는 단계이다. 무선통신을 통해 목표로버의
배터리마운트 덮개를 다시 덮고, 로봇팔을 홈포
지션으로 되돌려 보내며, 영상처리 프로세서와도
통신을 종료하는 일련의 과정을 실행하여 로봇팔
을 교체임무 시작전의 상황으로 되돌린다.

2.4.3 Software Configuration
임무수행과 이를 보조하기 위한 기타 기능들을
구현하기위해 두 아두이노 프로세서의 프로그래
밍을 진행하였다. 각 프로세서에 구현된 기능은
아래와 같다. 아두이노 듀에(Due)

l 컴퓨터와 UART 및 Bluetooth 통신 l nRF24L01 모듈과 SPI 통신
l 라즈베리파이와 UART 통신
l Uno와 UART 통신
l 캘리브레이션
l DC 또는 Servo모터의 수동조작
l 좌표입력을 통한 이동
l 임무수행

아두이노 우노(Uno)
l Due와 UART 통신
l 2개의 기저부 DC모터 제어

KSME Template | 17

l 캘리브레이션값 EEPROM 저장
이때 듀에는 컴퓨터 및 스마트폰과 UART 또는
Bluetooth 통신을 수행하여 작업자의 명령을 처 리할 수 있으며, nRF24L01 모듈과 SPI 통신하여 무선통신을 수행할 수 있다. 또한 Uno와 UART통 신을 통해 각종 필요한 정보들을 교환할 수 있
다. 이를 바탕으로, 듀에는 캘리브레이션을 진행 하여 미세한 각도오차를 보정할 수 있으며, 작업 자에 의하여 각 관절의 각도를 수동으로 제어할
수 있다. 또 로봇팔의 엔드이펙터를 원하는 좌표 로 보낼 수 있다. 마지막으로, 해당 기능들을 전 부 사용하여 자동 배터리교체임무를 수행 할 수
있다. 우노는 UART 통신을 통해 듀에로부터 DC모터 각

도값을 받거나 캘리브레이션값들을 받을 수 있
다. | 이로부터 | 2개의 | DC모터를 | 제어하거나,
EEPROM을 활용하여 캘리브레이션값들을 비휘발성 메모리에 저장한뒤 듀에가 재가동했을 때 이를
다시 전달해줄 수 있다.
3. 결 론

본 연구는 우주환경에서 타겟 로버의 배터리를
교체하는 로봇팔 시스템으로서 마커를 이용하여
사물 인식, 거리 및 자세 측정, 경로 생성, 작동 하는 시스템이다. 배터리, 영상처리 파트 등이 융 합된 시스템에서 본 논문은 로봇팔 설계 및 제작 과 실험에 중점을 두고 있다. 임무를 위한 로봇 팔은 System engineering 기법인 V-shape diagram 을 따라 개발되었다. 향후 과제로서, 일부 조인트에서의 토크 부족

과 마찰감소, 로봇팔의 작동 정확성 개선 등이
존재한다. 엔드이펙터의 경우 배터리팩을 잡고
배터리팩의 무게 5.3955N과 로봇팔 작동시의 추 가적인 관성력을 견뎌야 한다는 요구조건은 독립
적으로 만족하였다. 또한 조인트 서보의 토크를
고려한 엔드이펙터 총 질량제한(200g 이하)을 만 족시켰다. 하지만 로봇팔의 작동 정확성을 검증
하기 위한 최종 결합 후 시험은 진행하지 못하였 다. 엔드이펙터가 영상처리팀에서 제공한 배터리
팩 위치에 정확히 도달할 수 있는지에 대한 검증 이 필요하다. 만약 해당 위치에 정확히 도달하였

는데도 그립과정에 문제가 있다면 패스플랜의 수
정 또는 영상처리의 정확성 개선이 요구된다. 또 한 우리가 만든 로봇 팔은 각각의 서보 모터 내 의 피드백 루프 시스템을 신뢰하여 로봇 팔 전체 의 움직임에 대해서는 피드 백 시스템이 없다. 이러한 방법은 미션 수행이 정확하게 이루어지고

있는지에 대한 신뢰성이 떨어진다. 이에 따라 로 봇 팔 자체가 배터리를 정확하게 집었는지 확인
할 수 있는 별도의 센서를 추가하여 미션 수행에 대한 신뢰성을 높일 필요가 있다. 또한, 비록 사용된 액추에이터가 모두 12V 이

하라는 점에서 제한조건을 만족시키기는 하였으
나, 결과적으로 토크부족이 발생하였다. 12V 이 하의 액추에이터 중 조건을 만족하는 액추에이터
의 폭이 넓지 않아 대체에 어려움이 있었으며, 교환 배터리만으로 전력을 충당하기에는 요구 사

항이 높았던 것으로 분석된다. 따라서 제한조건
외의 환경에서 추가적인 전력이 공급이 요구된
다.배터리 자동교체 시스템은 우주환경 뿐만 아니

라 다양한 산업군에서 적용될 수 있다. 배터리가 아니라 부품/장비라고 가정한다면 스마트 플랜트
라인이나 복잡한 환경에서 어시스턴트 의료 로보
등 활용될 분야는 무궁무진하다. 앞서 언급한 향 후 과제를 해결함으로서 이처럼 다양하고 복잡한
환경속에서 다양한 임무를 수행해낼 수 있을 것
이다. | 후 기

본 연구는 한국항공대학교 캡스톤 디자인 과
제의 일환으로 진행된 연구이며, 협력해 주신 모 든 분들께 감사드립니다. 특히 지도교수이며, 함 께 배우며, 방향을 제시해 주신 장대성 교수님께 감사를 표합니다. 참고문헌

(References)

(1) Richard G. Budynas, J. Keith Nisbett, 2013, "Shigley's Mechanical Engineering Design, 9

th

Ed.", McGraw-Hill
(2) Saeed B. Niku, 2011, "Introduction to Robotics, 2

nd Ed." Wiley.
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
